TKWTL/Desktop_PD_Power_Converter/Docs/TEST_REPORT.md

# 测试报告(Test Report)

> 本报告记录在**完成装配的工程样机**上进行的验证测试。除特别说明外,均使用本节
> 所列固件版本、仪器与测试条件。所有空白项以实际测试数据填写后发布。

测试环境

<!-- 待拍:测试台全景(仪器接线、被测整机、负载) -->

## 1. 测试环境与仪器

| 项目 | 内容 |
|---|---|
| 固件版本 / commit | 待填 |
| 硬件版本 | v1.0(首版) |
| 环境温度 | 待填(建议 25 ± 2 °C,记录实际值) |
| 输入源 | 待填(DC 电源 / PD 适配器型号与能力) |
| 电子负载 | 待填(型号、模式 CC/CR) |
| 万用表 | 待填 |
| 示波器 | 待填(带宽、探头) |
| PD 协议分析/诱骗器 | 待填(如使用) |
| 温度记录 | 待填(板载传感器 + 外置热电偶/热像仪) |

## 2. USB-PD / EPR 兼容性测试

### 测试条件

- 多款 PD 适配器(SPR 党 / EPR 党),涵盖 65 W–140 W;
- 每款记录:SPR 是否成功、EPR 28 V 是否成功、冷插拔、软件复位后重协商、连续运行。

### 结果

| 适配器 | 额定功率 | SPR | EPR 28 V | 冷插拔 | 复位后重协商 | 连续运行 |
|---|---|---|---|---|---|---|
| 待填 | 待填 | 待填 | 待填 | 待填 | 待填 | 待填 |

EPR 协商

<!-- 待放:协议分析仪/仪表盘显示 28 V EPR 的照片或截图 -->

### 分析

待填。

## 3. 端口能力测试(单控制器最大能力)

### 测试条件

- 每口单独加载,逐步升载到控制器上限附近;记录最大稳定输出功率与压降;
- 输入条件:DC / PD(按端口需求选择),记录输入功率。

### 结果

| 端口 | 控制器 | 目标上限 | 实测最大稳定输出 | 输入功率 | 备注 |
|---|---|---|---|---|---|
| A + C | SW3538 | ≤140 W | 待测 | 待测 | 双口合计 |
| C1 | SW3526 #1 | ≤65 W | 待测 | 待测 | |
| C2 | SW3526 #2 | ≤65 W | 待测 | 待测 | |

### 分析

待填。

## 4. 整机最大持续输出与温升

### 测试条件

- 从冷机开始,阶梯加载:25%(10 min)→ 50%(10 min)→ 75%(15 min)→
  到允许的最大持续负载并维持到温度稳定;
- **稳定判据:连续 10 min 内最高温度变化 < 2 °C**;
- 每 30 s–1 min 记录:输入 V/I、各口 V/I/P、板载温度、风扇 PWM、VBUS、PD 状态。

### 结果

温升曲线

<!-- 待放:温度/功率-时间曲线图 -->

| 阶段 | 负载 | 持续时间 | 最高温度 | 风扇 PWM | 现象 |
|---|---|---|---|---|---|
| 25% | 待填 | 10 min | 待填 | 待填 | 待填 |
| 50% | 待填 | 10 min | 待填 | 待填 | 待填 |
| 75% | 待填 | 15 min | 待填 | 待填 | 待填 |
| 最大持续 | 待填 | 到稳定 | 待填 | 待填 | 待填 |

### 分析

待填(是否降额、是否触发保护、是否重协商)。

## 5. 自动功率分配测试

### 测试条件

- 固定输入预算,构造下列场景;记录插入顺序与固件分配结果。

### 场景矩阵

| 场景 | 输入预算 | A+C 分配 | C1 分配 | C2 分配 | 总输出 | 结果 |
|---|---|---|---|---|---|---|
| 只有 C1 | 待填 | — | 待填 | — | 待填 | 待测 |
| 只有 C2 | 待填 | — | — | 待填 | 待填 | 待测 |
| 只有 A+C | 待填 | 待填 | — | — | 待填 | 待测 |
| C1 + C2 | 待填 | — | 待填 | 待填 | 待填 | 待测 |
| C1 + A+C | 待填 | 待填 | 待填 | — | 待填 | 待测 |
| C2 + A+C | 待填 | 待填 | — | 待填 | 待填 | 待测 |
| 全部接入 | 待填 | 待填 | 待填 | 待填 | 待填 | 待测 |

### 动态场景

| 场景 | 现象 | 重分配耗时 | 掉线/重协商 | 结果 |
|---|---|---|---|---|
| 插入顺序 C1 → C2 | 待填 | 待填 | 待填 | 待测 |
| C1 从 5 V 设备换成 20 V 65 W 设备 | 待填 | 待填 | 待填 | 待测 |
| 拔掉大功率设备 | 待填 | 待填 | 待填 | 待测 |

### 分析

待填。

## 6. 风扇控制测试

### 测试条件

- 用负载/热风控制温度,记录 40/37 °C 迟滞与 PWM-温度曲线;
- 验证冷启动起转、异响、满载风量、传感器失效保底。

### 结果

| 条件 | 期望 | 实测 | 结果 |
|---|---|---|---|
| < 37 °C | 停转 | 待填 | 待测 |
| 37–40 °C | 保持迟滞状态(不启动/不停) | 待填 | 待测 |
| ≥ 40 °C | 启动 | 待填 | 待测 |
| 41 / 45 / 50 °C | PWM 逐档提高 | 待填 | 待测 |
| 降温 40 → 37 °C | 40 °C 不停转,≤37 °C 停 | 待填 | 待测 |
| 冷启动起转 | 可靠起转、无嗡鸣 | 待填 | 待测 |
| 传感器失效 | 全速 | 待填 | 待测 |
| 输入 UVP | 停转 | 待填 | 待测 |

温度-PWM 曲线

<!-- 待放:温度-PWM 曲线图 -->

### 分析

待填。

## 7. 输出纹波测试

### 测试条件(固定方法)

- 示波器:**AC 耦合**、**20 MHz 带宽限制**、探头 ×10;
- 接地:**短地弹簧/极短地线**(禁止 10 cm 鳄鱼夹地线);
- 测量点:输出连接器附近(输出电容两端);记录值:Vpp;
- 工况:空载 / 25% / 50% / 75% / 接近额定。

### 结果

| 端口 | 电压 | 负载 | Ripple Vpp | 条件 |
|---|---|---|---|---|
| 待填 | 待填 | 待填 | 待填 | 20 MHz |
| 待填 | 待填 | 待填 | 待填 | 20 MHz |

典型轻载纹波
典型满载纹波
最差工况纹波

<!-- 待放:三类波形(轻载/满载/最差),其余波形留档不发布 -->

### 分析

待填。

## 8. 长时间稳定性测试

### 三个层次

| 层次 | 设置 | 时长 | 结果 |
|---|---|---|---|
| 热浸 | 最大持续负载 | 1–2 h | 待测 |
| 持续运行 | 70–80% 系统负载 | 6–8 h | 待测 |
| 真实使用 | 作为桌面充电器日常使用 | 数天 | 待测 |

### 异常事件计数(重点记录)

| 事件 | 次数 | 备注 |
|---|---|---|
| PD 掉线(握手丢失) | 待填 | |
| EPR 重新协商 | 待填 | |
| 端口重启 | 待填 | |
| I²C 总线恢复 | 待填 | |
| 看门狗(IWDG)复位 | 待填 | |
| 最高温度 | 待填 | |
| VBUS 最低/最高 | 待填 | |
| 风扇异常(停转/异响) | 待填 | |
| OLED / UI 卡死 | 待填 | |

### 分析

待填(建议先在固件中加入运行统计计数以便读取,当前可通过串口日志统计)。

## 9. 测试结论

待填(汇总:可稳定达到的持续输出、温升水平、兼容性结论、遗留问题)。

---

## 附:报告填写约定

- 所有表格中的"待填/待测"替换为实测值,并注明**测试条件**(输入、负载、环境温度);
- 每个测试节保留"测试条件 / 测试结果 / 分析"三段结构,便于固件升级后复测复用;
- 图片放入 [`../Images/Testing/`](../Images/Testing/),命名与文中路径一致。
