TKWTL/Desktop_PD_Power_Converter/Hardware/Preview/SCH_Desktop_PD_Power_Converter_主板.pdf

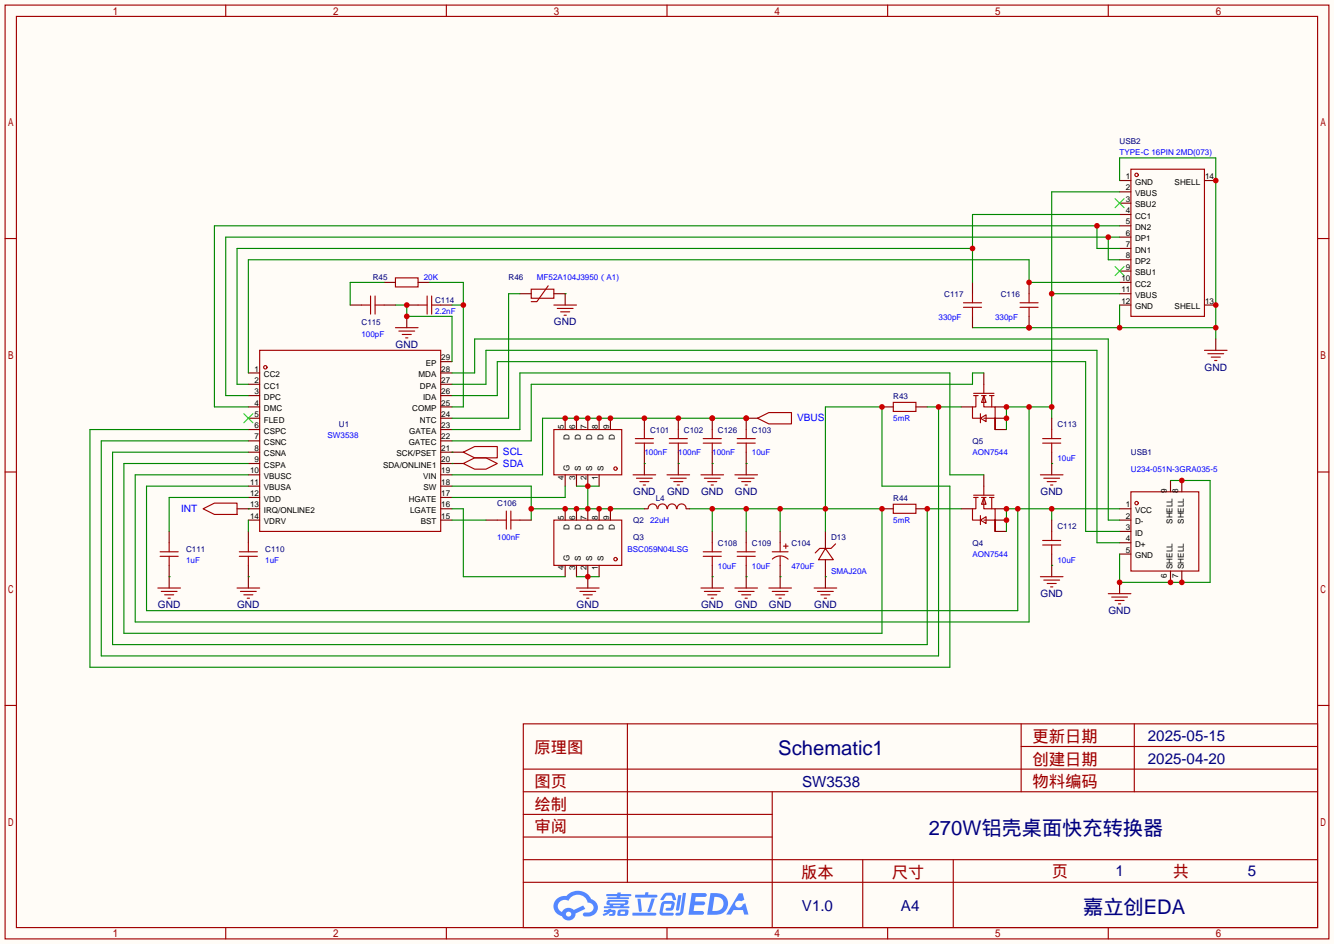
[picture p1: page 1]

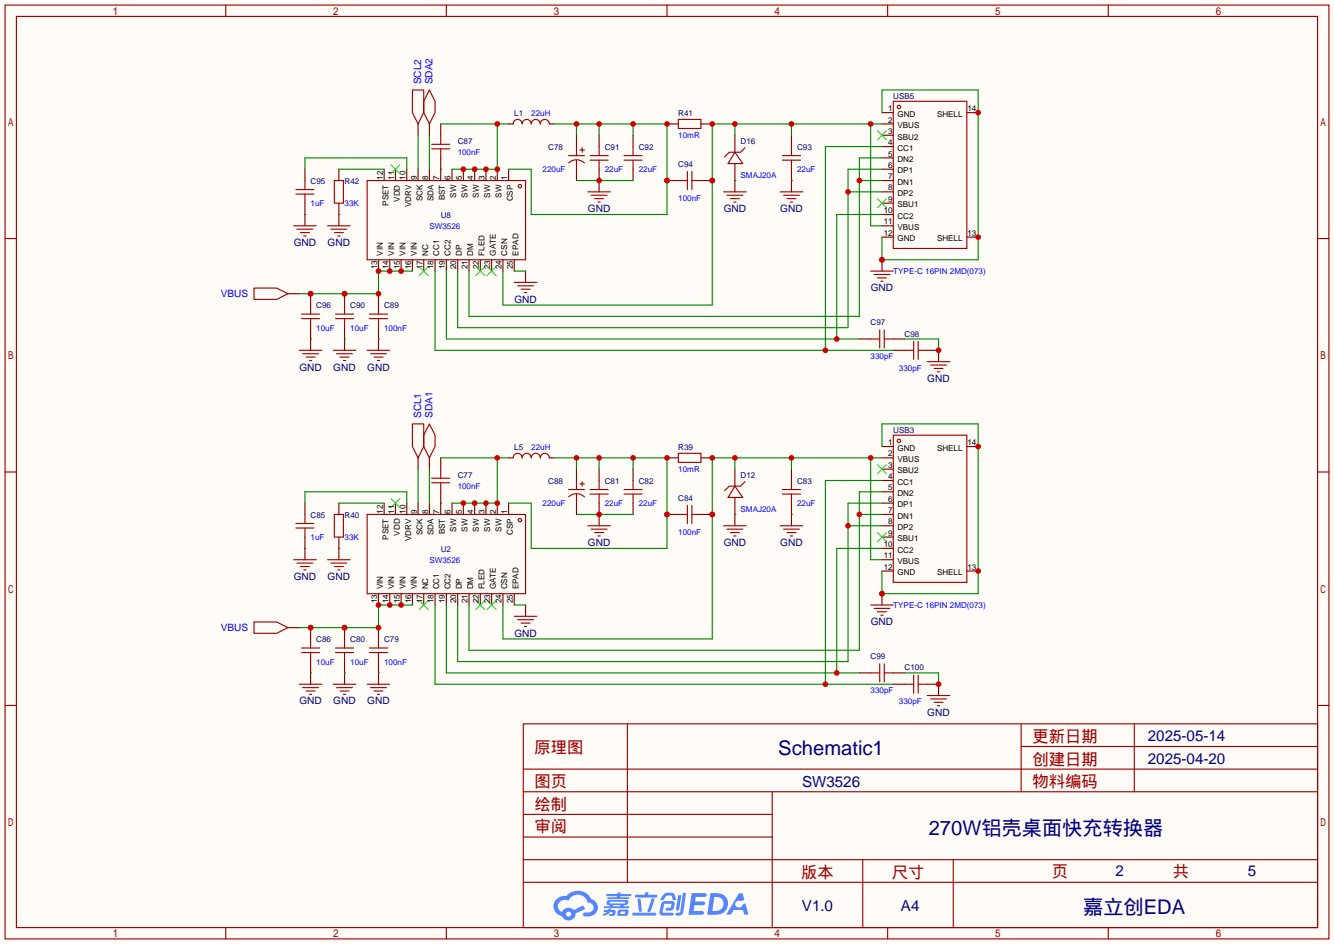
[picture p2: page 2]

9 VDRV 10 VDD 11 PSET 12 VIN 13 VIN 14 VIN 15 VIN 16

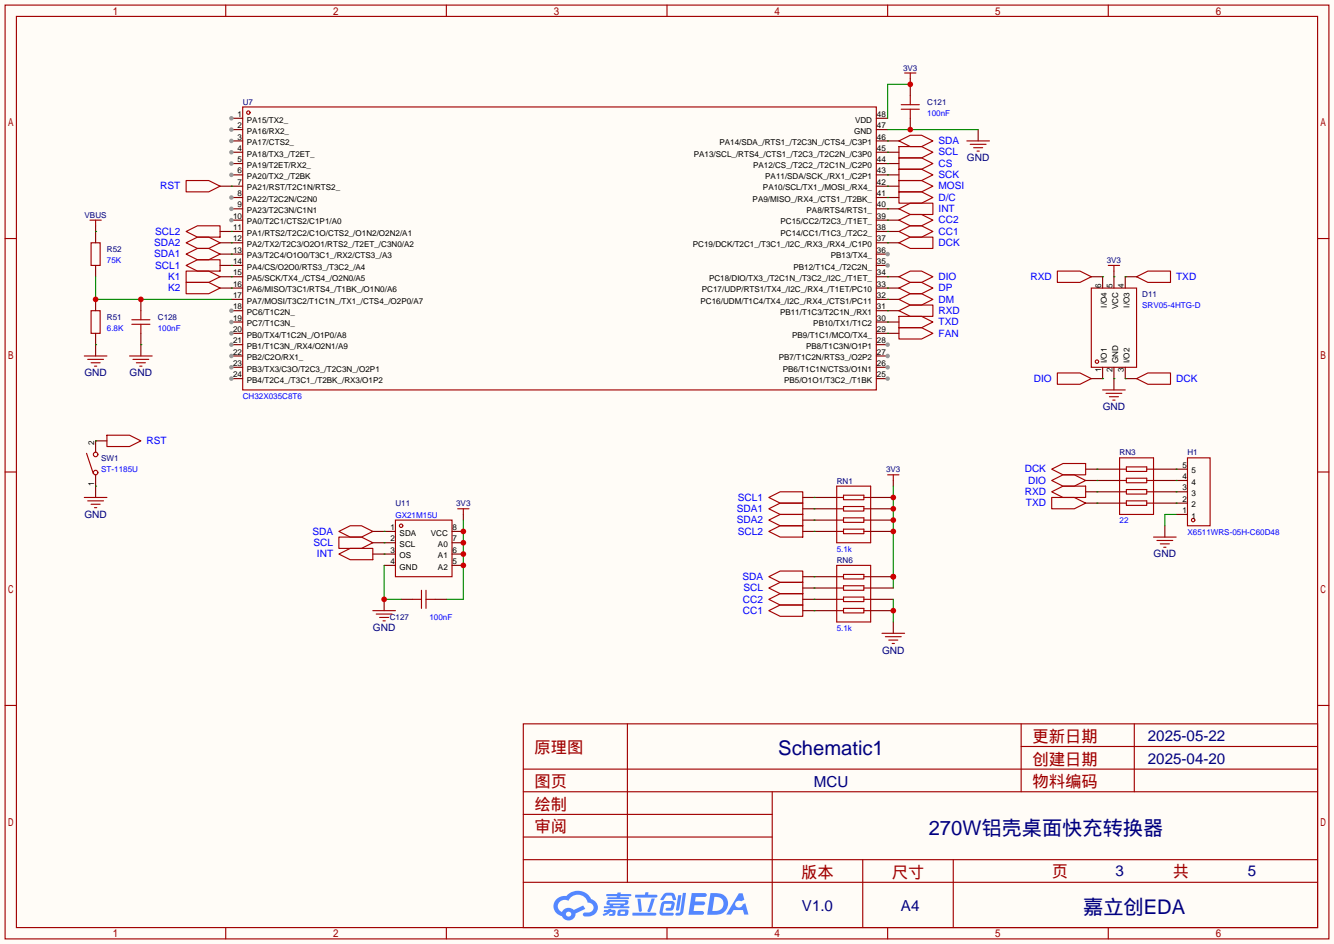
[picture p3: page 3]

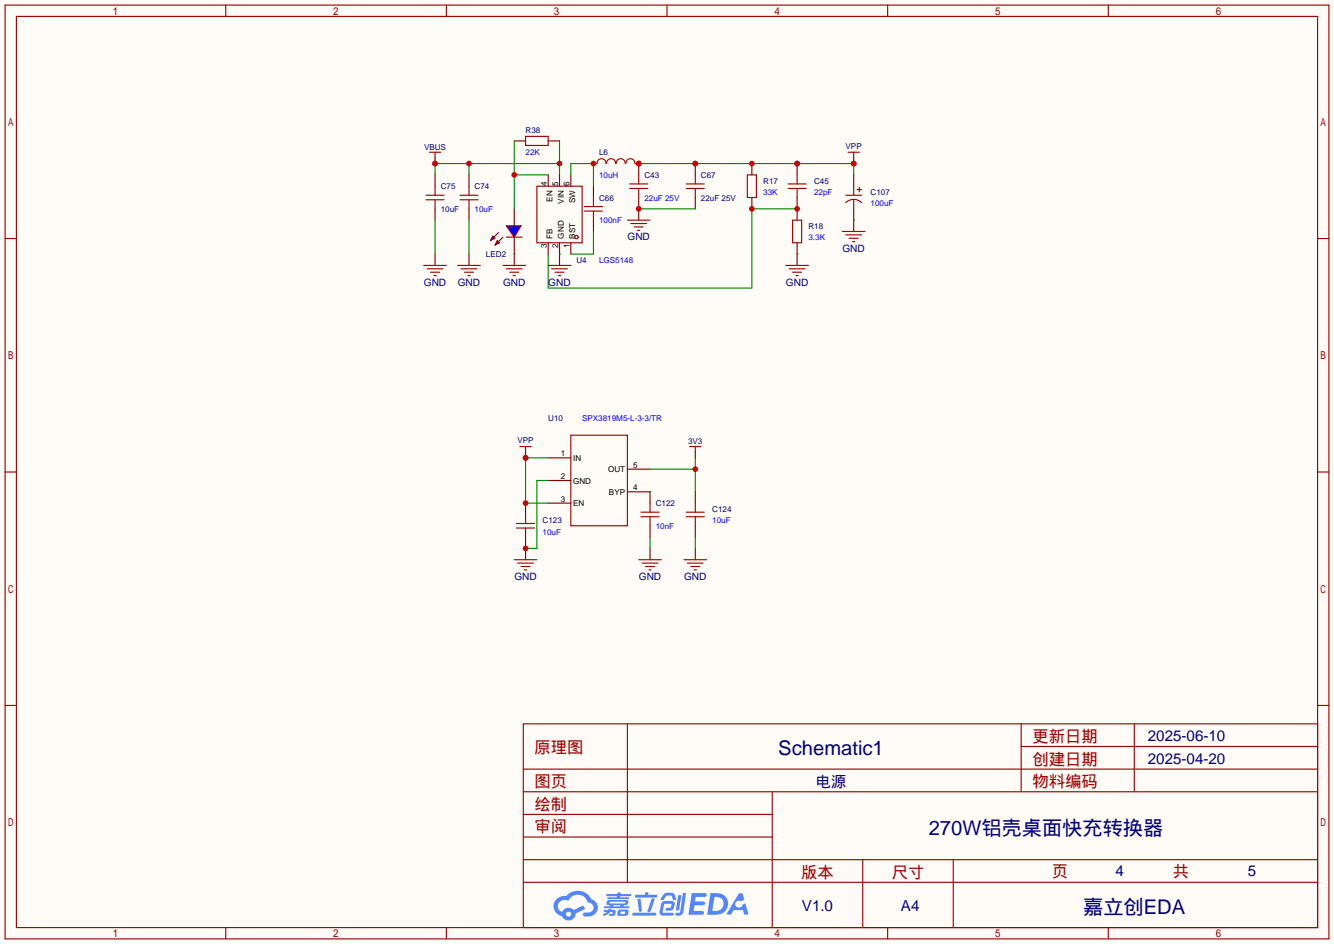
[picture p4: page 4]

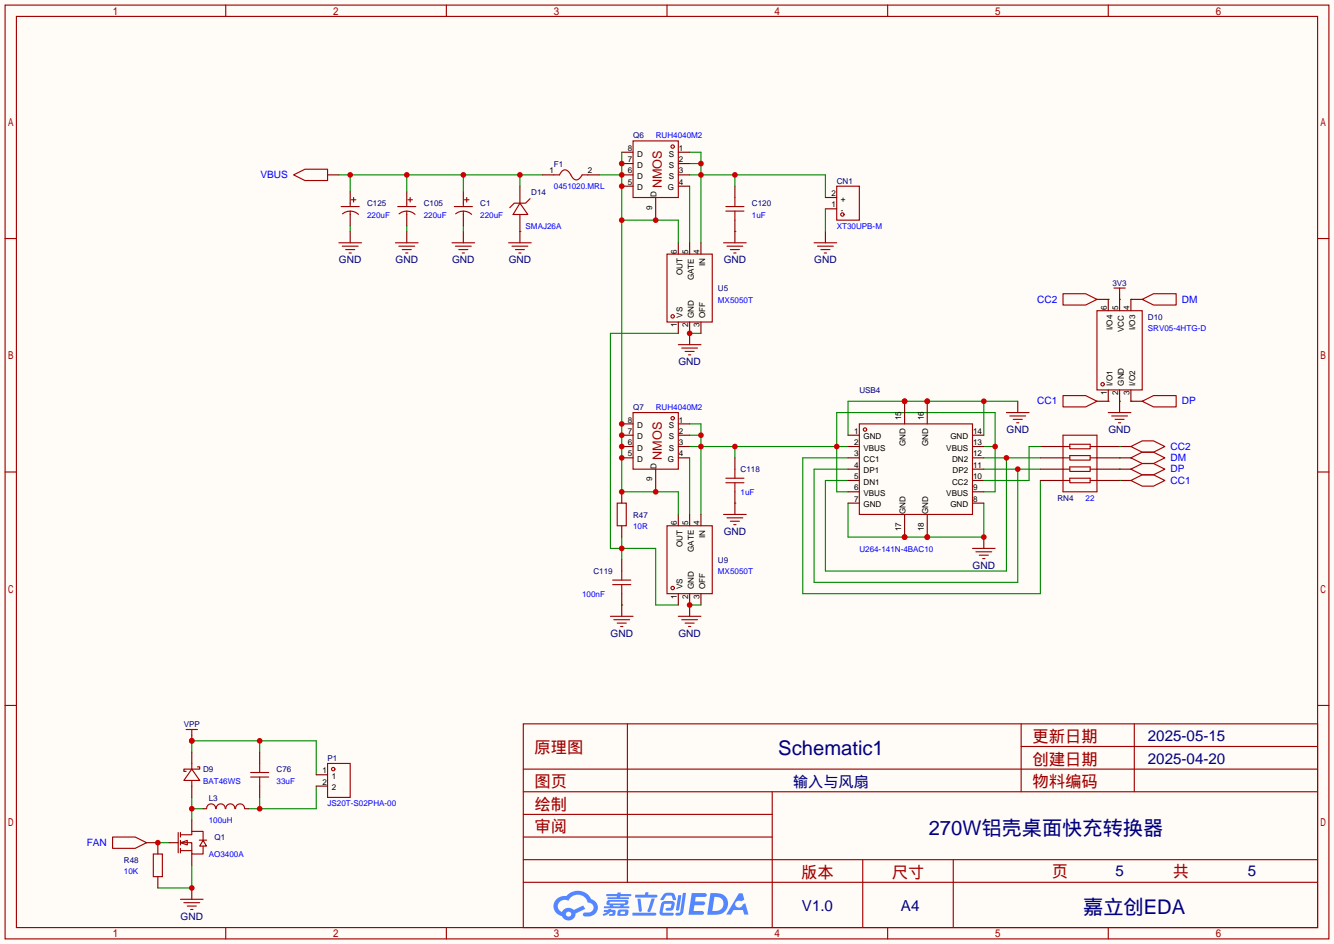
[picture p5: page 5]
