TKWTL/Desktop_PD_Power_Converter/Hardware/Preview/SCH_Desktop_PD_Power_Converter_内面板.pdf

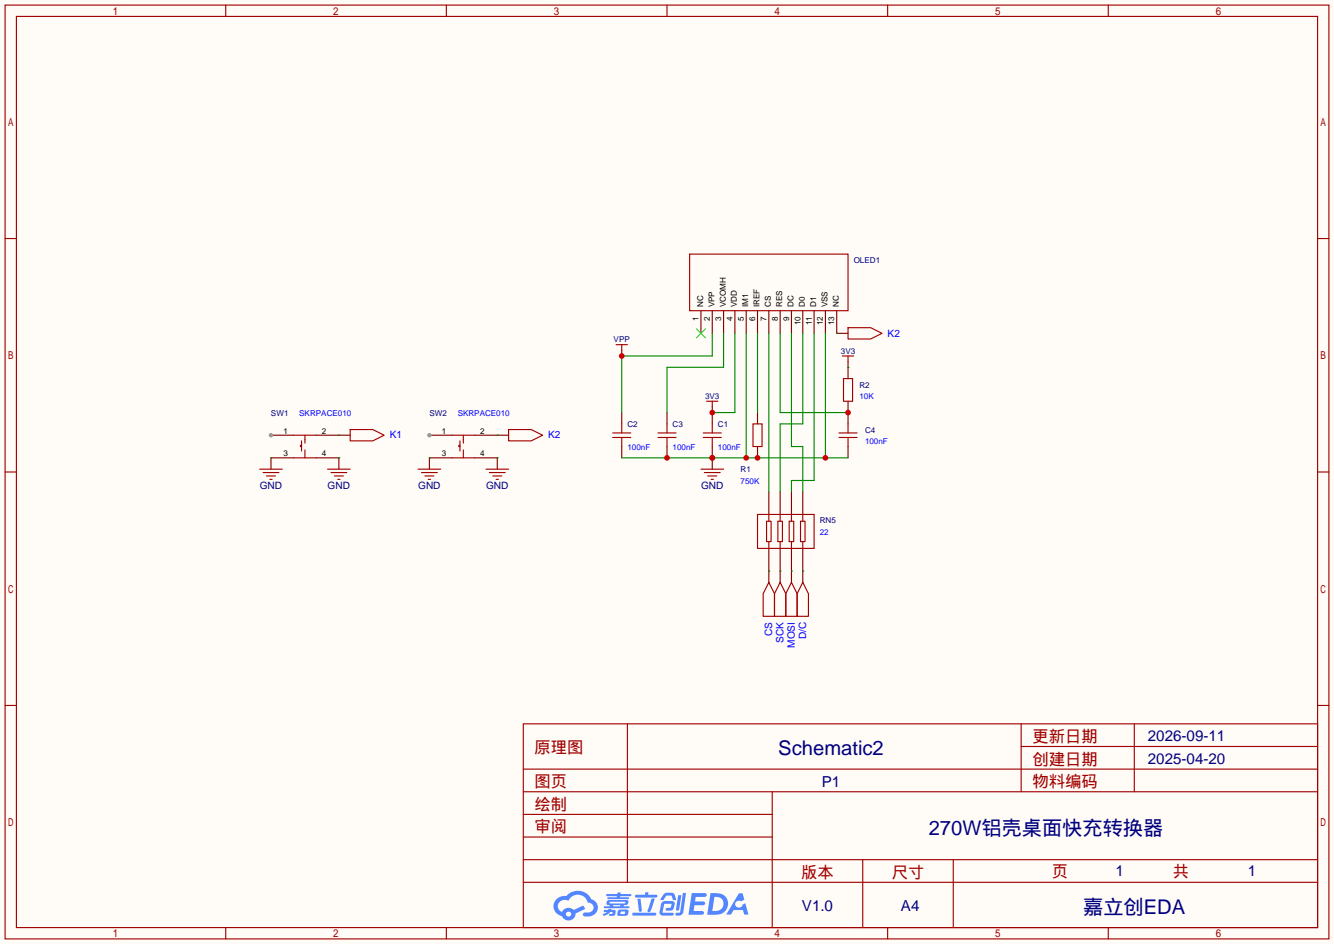
[picture p6: page 1]
