TKWTL/Desktop_PD_Power_Converter/(commit log)

2026-09-12 chore: initial commit of the desktop USB-PD power converter firmware
    桌面 USB-PD 电源转换器固件首次入库：MounRiver Studio II 工程 + APP/BSP/Peripheral/Project 分层源码 + 中文文档 + AGPL-3.0。
    - CH32X035C8T6 (RISC-V QingKe): PD 3.1 Sink，SPR 20V/3A，EPR 目标 28V/5A (140W)
    - 驱动: SW3538 + 2x SW3526 遥测、SH1107 OLED (MiaoUI)、USART1/I2C1/SPI1 中断+DMA
    - 文档: README / FIRMWARE_ARCHITECTURE / PORTING_NOTES / 各模块 README
2026-09-12 排查EPR问题
2026-09-14 添加许多功能
